BlinqR/Room-Control/hardware/mk1/schematic.pdf

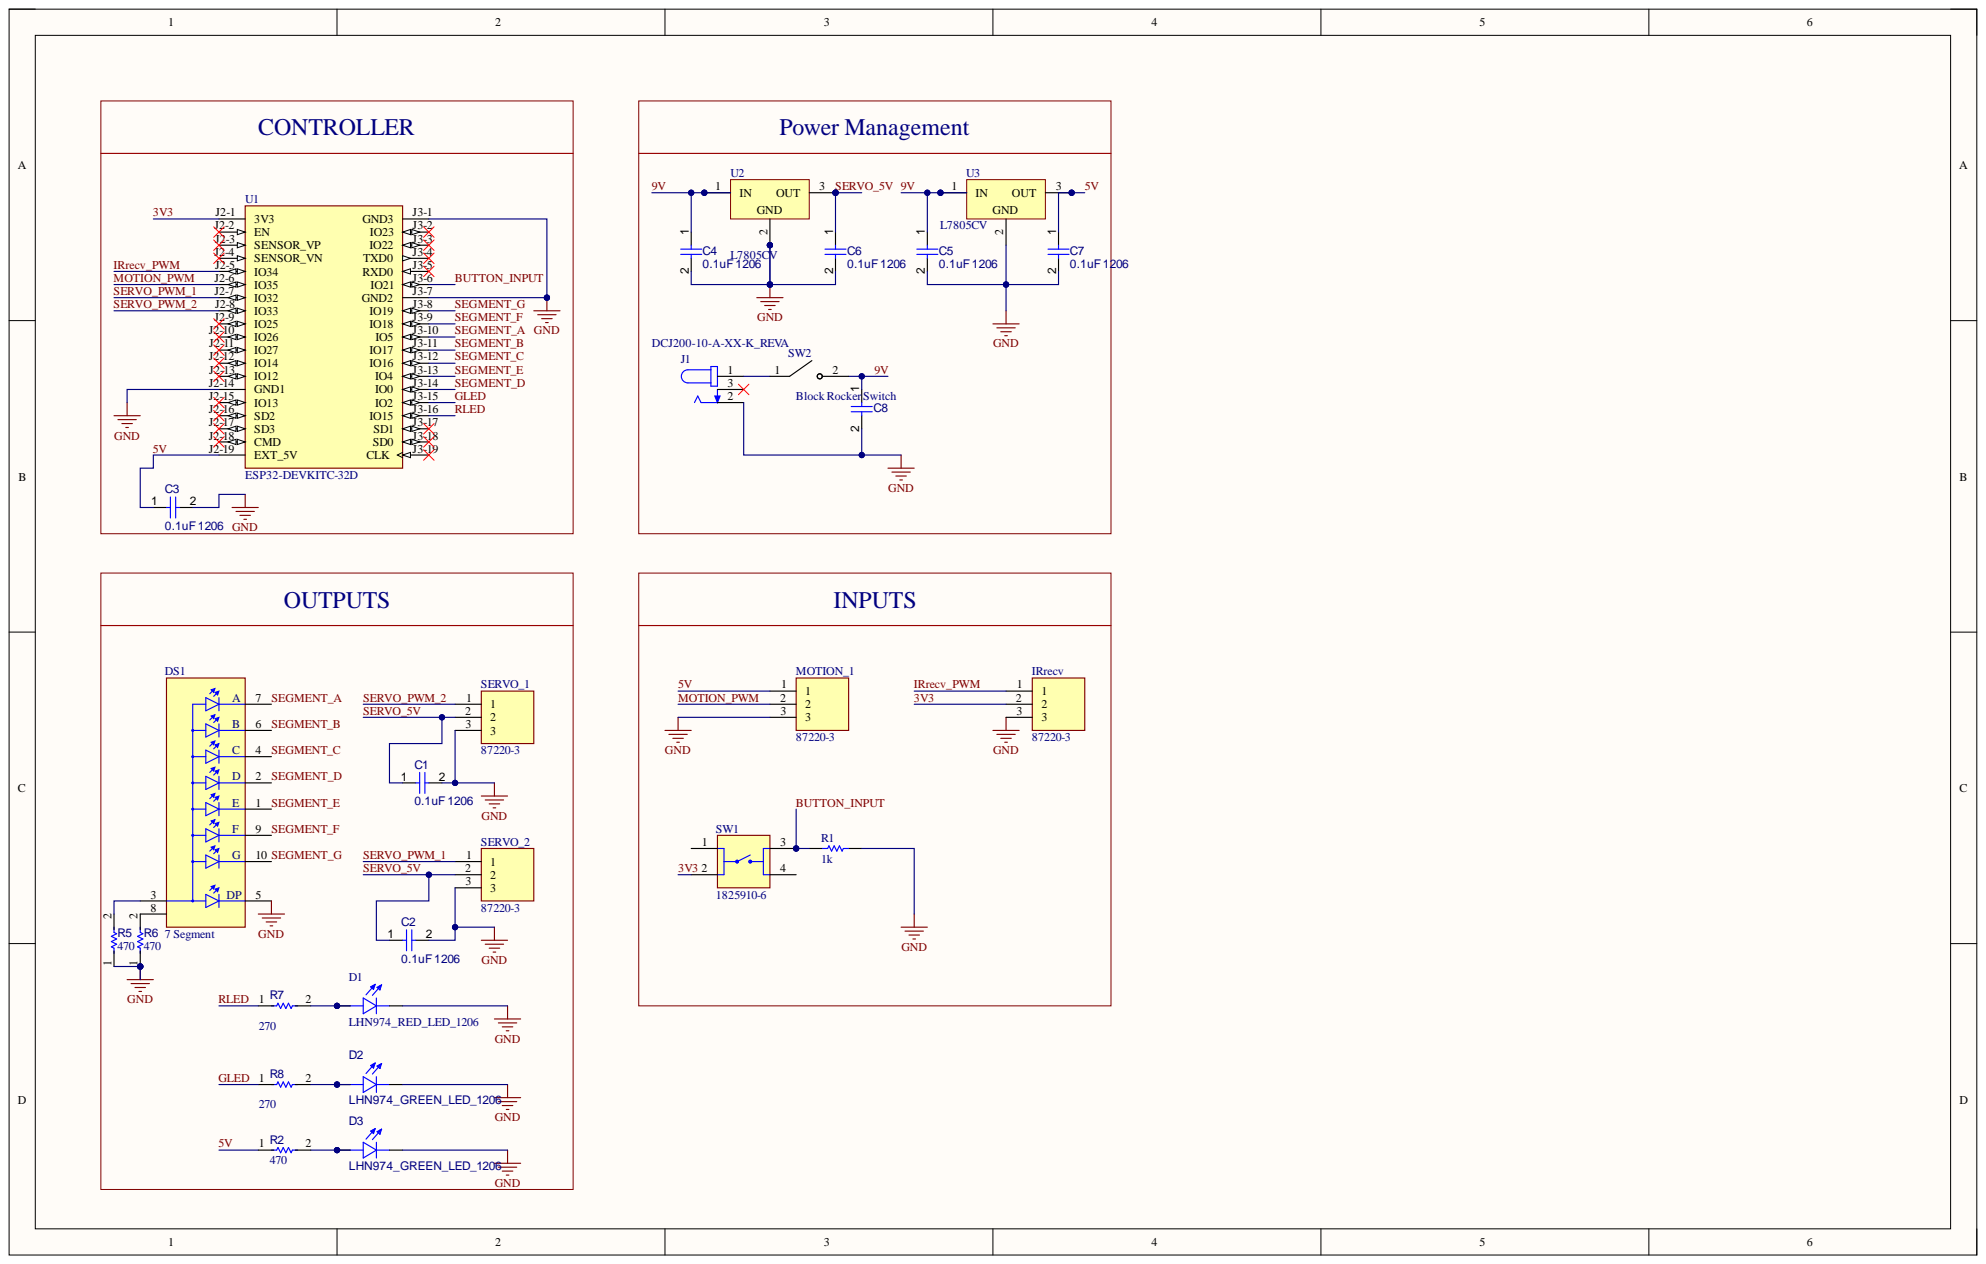
[picture p1: page 1]
