BlinqR/Room-Control/(commit log)

2026-09-19 Add countdown abort and AC toggle window handling
    Status LED:
    - Turn the red LED on at boot and clear it once WiFi connects
    Leave-room countdown:
    - Pressing the button again during the 9s countdown aborts it, sets
    inRoom back to 1 and turns the lights back on
    - Replace the blocking delay(1000) with a 10ms polling loop so the
    button can be read during the countdown
    - Wait for the initial press to be released (with debounce) so it isn't
    read as the abort press, and again after an abort so it doesn't
    restart the countdown
    AC toggle:
    - Split toggleAC() into pressACServo() plus a timing check
    - The AC takes ~3.3s to apply a toggle, so a toggle within that window
    of the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
    [Room_Control.ino]
2026-09-19 Added schematic pdf
2026-09-26 Rename schematic.pdf to hardware/mk1/schematic.pdf
    Moved schematic to mk1 folder
2026-09-26 Update README for mk1/mk2 folder structure
    Added board versions table, links to schematic and BOM, new firmware path, and a note about the missing pull-down on GPIO 35
2026-09-26 Update README.md
    Removed BOM and Schematic img
